BGrowl/STM32F767-balance-car/docs/protocol.md

# 串口和蓝牙协议

[返回首页](../README.md)

## 接口与帧格式

USART1：PA9 TX、PA10 RX，**9600 8N1**。蓝牙模块和 K230 使用相同的 ASCII 帧协议：以 `$` 开始，以 `#` 结束。接收缓冲区为 80 字节，发送时保持单帧小于 80 字节，不需要额外换行。

接收中断逐字节调用 `deal_bluetooth()`；完整帧由主循环的 `ProtocolCpyData()`、`Protocol()` 处理。虽然发送形式类似逗号分隔字段，解析器实际上依赖固定字符偏移，不能任意增加空格、改变前导字段宽度或省略占位字段。

## 常用运动指令

| 动作 | 完整指令 |
| --- | --- |
| 停止运动目标，继续平衡 | `$0,0,0,0,0,0,0,0,0,0#` |
| 前进 | `$1,0,0,0,0,0,0,0,0,0#` |
| 后退 | `$2,0,0,0,0,0,0,0,0,0#` |
| 左转 | `$3,0,0,0,0,0,0,0,0,0#` |
| 右转 | `$4,0,0,0,0,0,0,0,0,0#` |
| 原地左旋 | `$0,1,0,0,0,0,0,0,0,0#` |
| 原地右旋 | `$0,2,0,0,0,0,0,0,0,0#` |
| 视觉任务中值切换为 0.2°，并停止运动目标 | `$5,0,0,0,0,0,0,0,0,0#` |

停止命令不会关闭 H 桥，也不会切断平衡 PWM。若需紧急停止，需切断电机功率电源。

## PID 查询与更新

查询：

```text
$0,0,1,0,0,0,0,0,0,0#
```

恢复启动时保存的六个 PID 参数：

```text
$0,0,2,0,0,0,0,0,0,0#
```

恢复 PID 不会恢复 `Mid_Angle`。参数只更新在 RAM 中，不会保存到 Flash，重启后仍使用源码默认值。

同时更新三组参数的例子（对应本项目当前默认 PID）：

```text
$0,0,0,0,1,1,1,AP8.0,AD4.8,VP3.0,VI1.5,TP2.0,TD5.0#
```

| 字段 | 转换为内部变量 |
| --- | --- |
| AP | `Balance_Kp = AP × 100` |
| AD | `Balance_Kd = AD` |
| VP | `Velocity_Kp = VP × 100` |
| VI | `Velocity_Ki = VI` |
| TP | `Turn_Kp = TP × 100` |
| TD | `Turn_Kd = TD` |

查询返回 `$AP...,AD...,VP...,VI...,TP...,TD...#`；更新过程可能返回多个 `$OK#`。查询实现会发送两次结果，并调用一次 `HAL_Delay(5)`，会占用控制时间。

## 实现边界

- 当前没有校验和、消息序号和可靠的断线停车超时；一次前进命令可能持续生效。
- 解析器对异常帧和 PID 数值长度的校验不完整，部分临时缓冲区很小；只向可信、本地接线的设备开放，先使用上面的短指令。
- 程序在完整长度检查之前就处理运动状态；错误帧不能视为一定没有执行。
- `UART5_Send_*` 是历史命名，实际发送使用 `huart1`，不是 UART5。
- 代码保留自动上报开关与组包函数，但当前主循环未调用 `SendAutoUp()`，部分遥测变量未赋有效数据，不能当作可用遥测功能。
- 一次只连接一个主动发送端，避免 K230、蓝牙和 USB 转串口同时争用 RX。
