BGrowl/STM32F767-balance-car/STM32F767-balance-car.ioc

Mcu.UserName=STM32F767IGTx
PA10.Signal=USART1_RX
PA13.Signal=SYS_JTMS-SWDIO
PA14.Signal=SYS_JTCK-SWCLK
PA6.Signal=S_TIM3_CH1
PA7.Signal=S_TIM3_CH2
PA9.Signal=USART1_TX
PB14.Signal=USB_OTG_HS_DM
PB15.Signal=USB_OTG_HS_DP
PB7.Signal=I2C1_SDA
PB8.Signal=I2C1_SCL
PC10.Signal=GPXTI10
PC14/OSC32_IN.Signal=RCC_OSC32_IN
PC15/OSC32_OUT.Signal=RCC_OSC32_OUT
PD12.Signal=S_TIM4_CH1
PD13.Signal=S_TIM4_CH2
PD4.Signal=GPIO_Output
PG13.Signal=GPIO_Output
PG14.Signal=GPIO_Output
PH0/OSC_IN.Signal=RCC_OSC_IN
PH1/OSC_OUT.Signal=RCC_OSC_OUT
PH10.Signal=S_TIM5_CH1
PH11.Signal=S_TIM5_CH2
PH4.Signal=GPXTI4
PI5.Signal=GPIO_Output
PI6.Signal=GPIO_Output
